dhaillant/midi8d/hardware/MIDI8d-V1.0-schematics-20210517.pdf

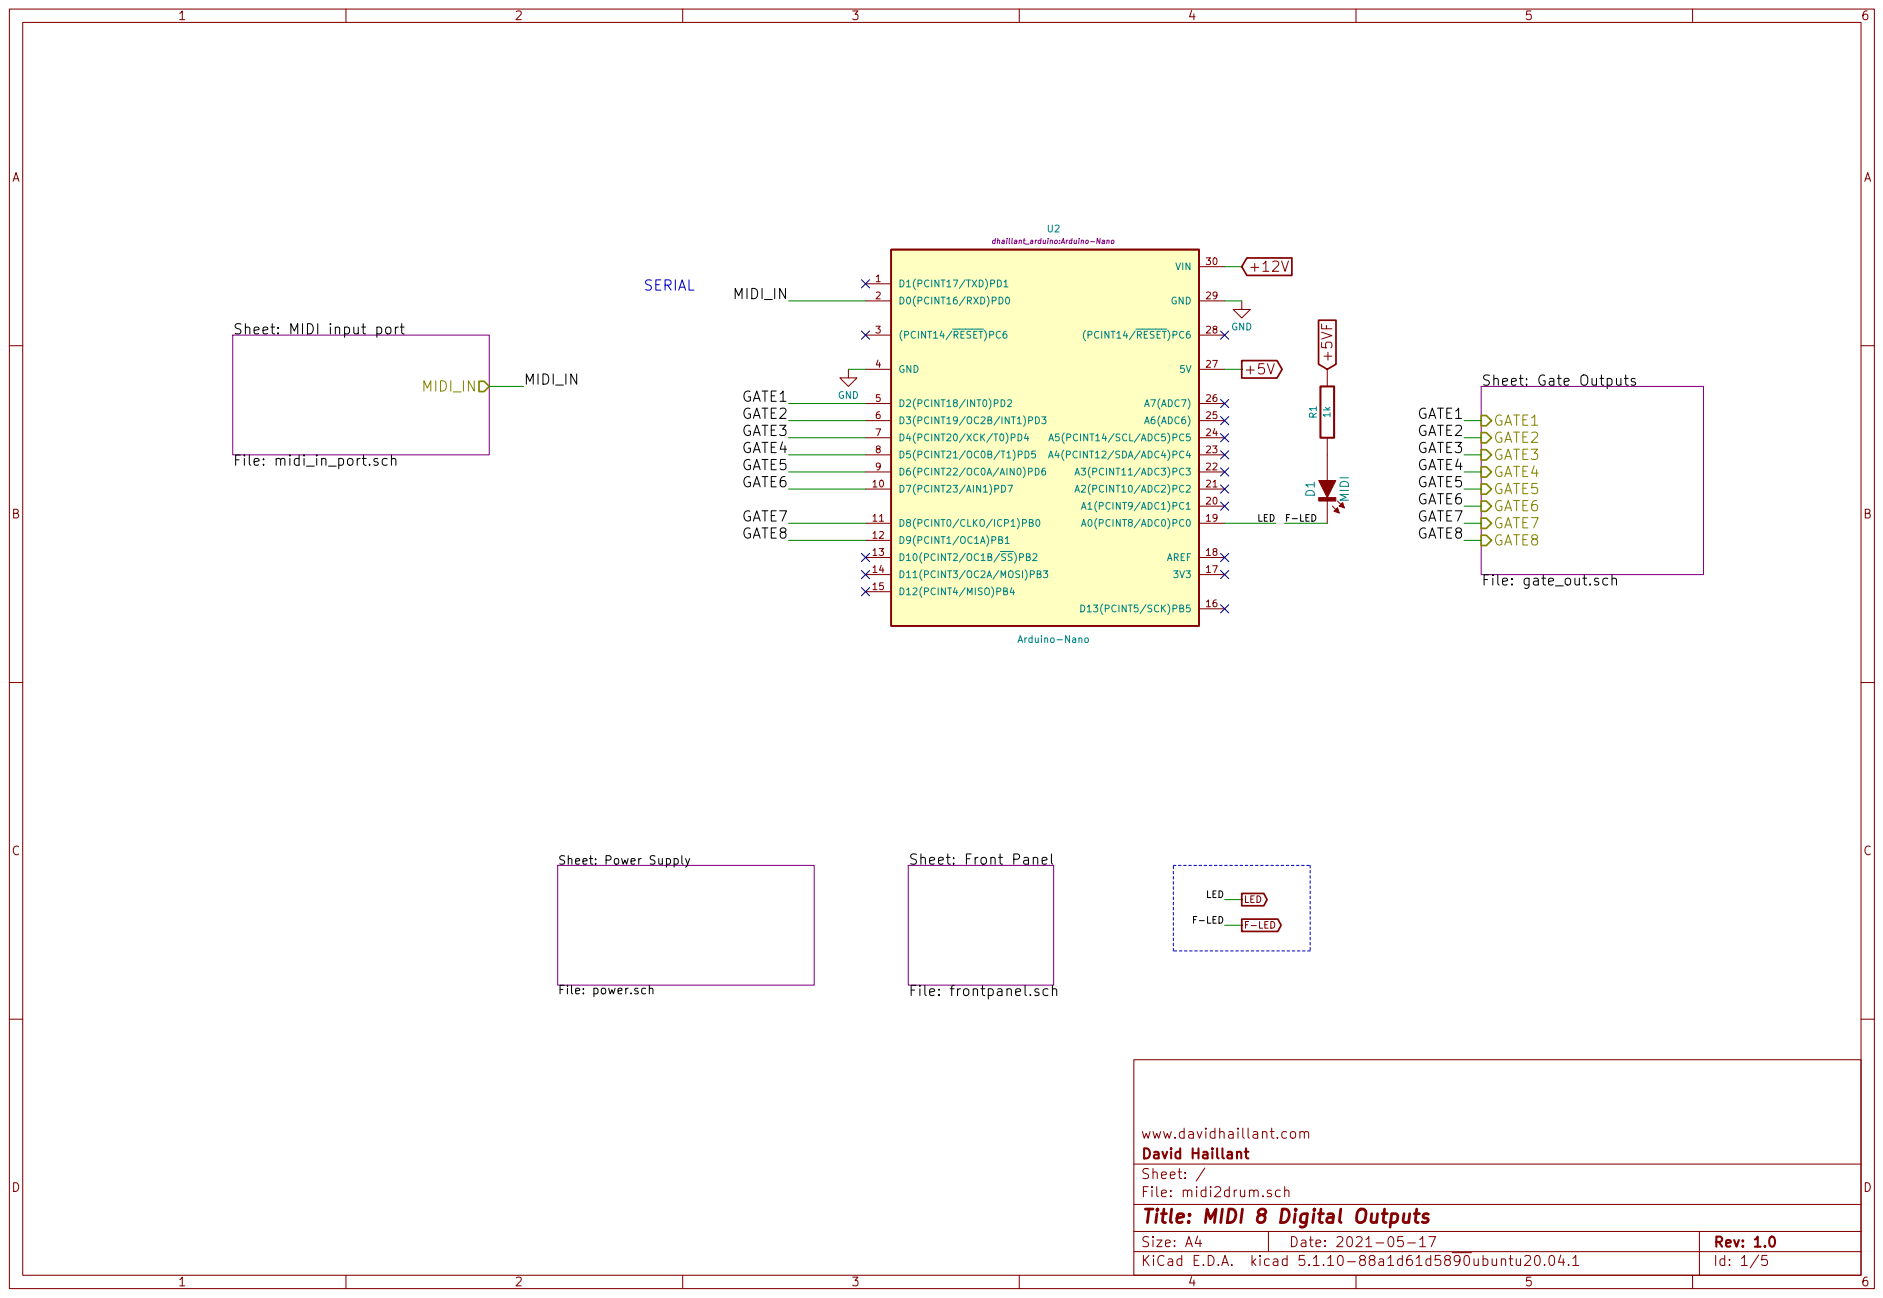
[picture p1: page 1]

Sheet: MIDI input port

File: midi2drum.sch Sheet: / David Haillant www.davidhaillant.com

Id: 1/5 Title: MIDI 8 Digital Outputs

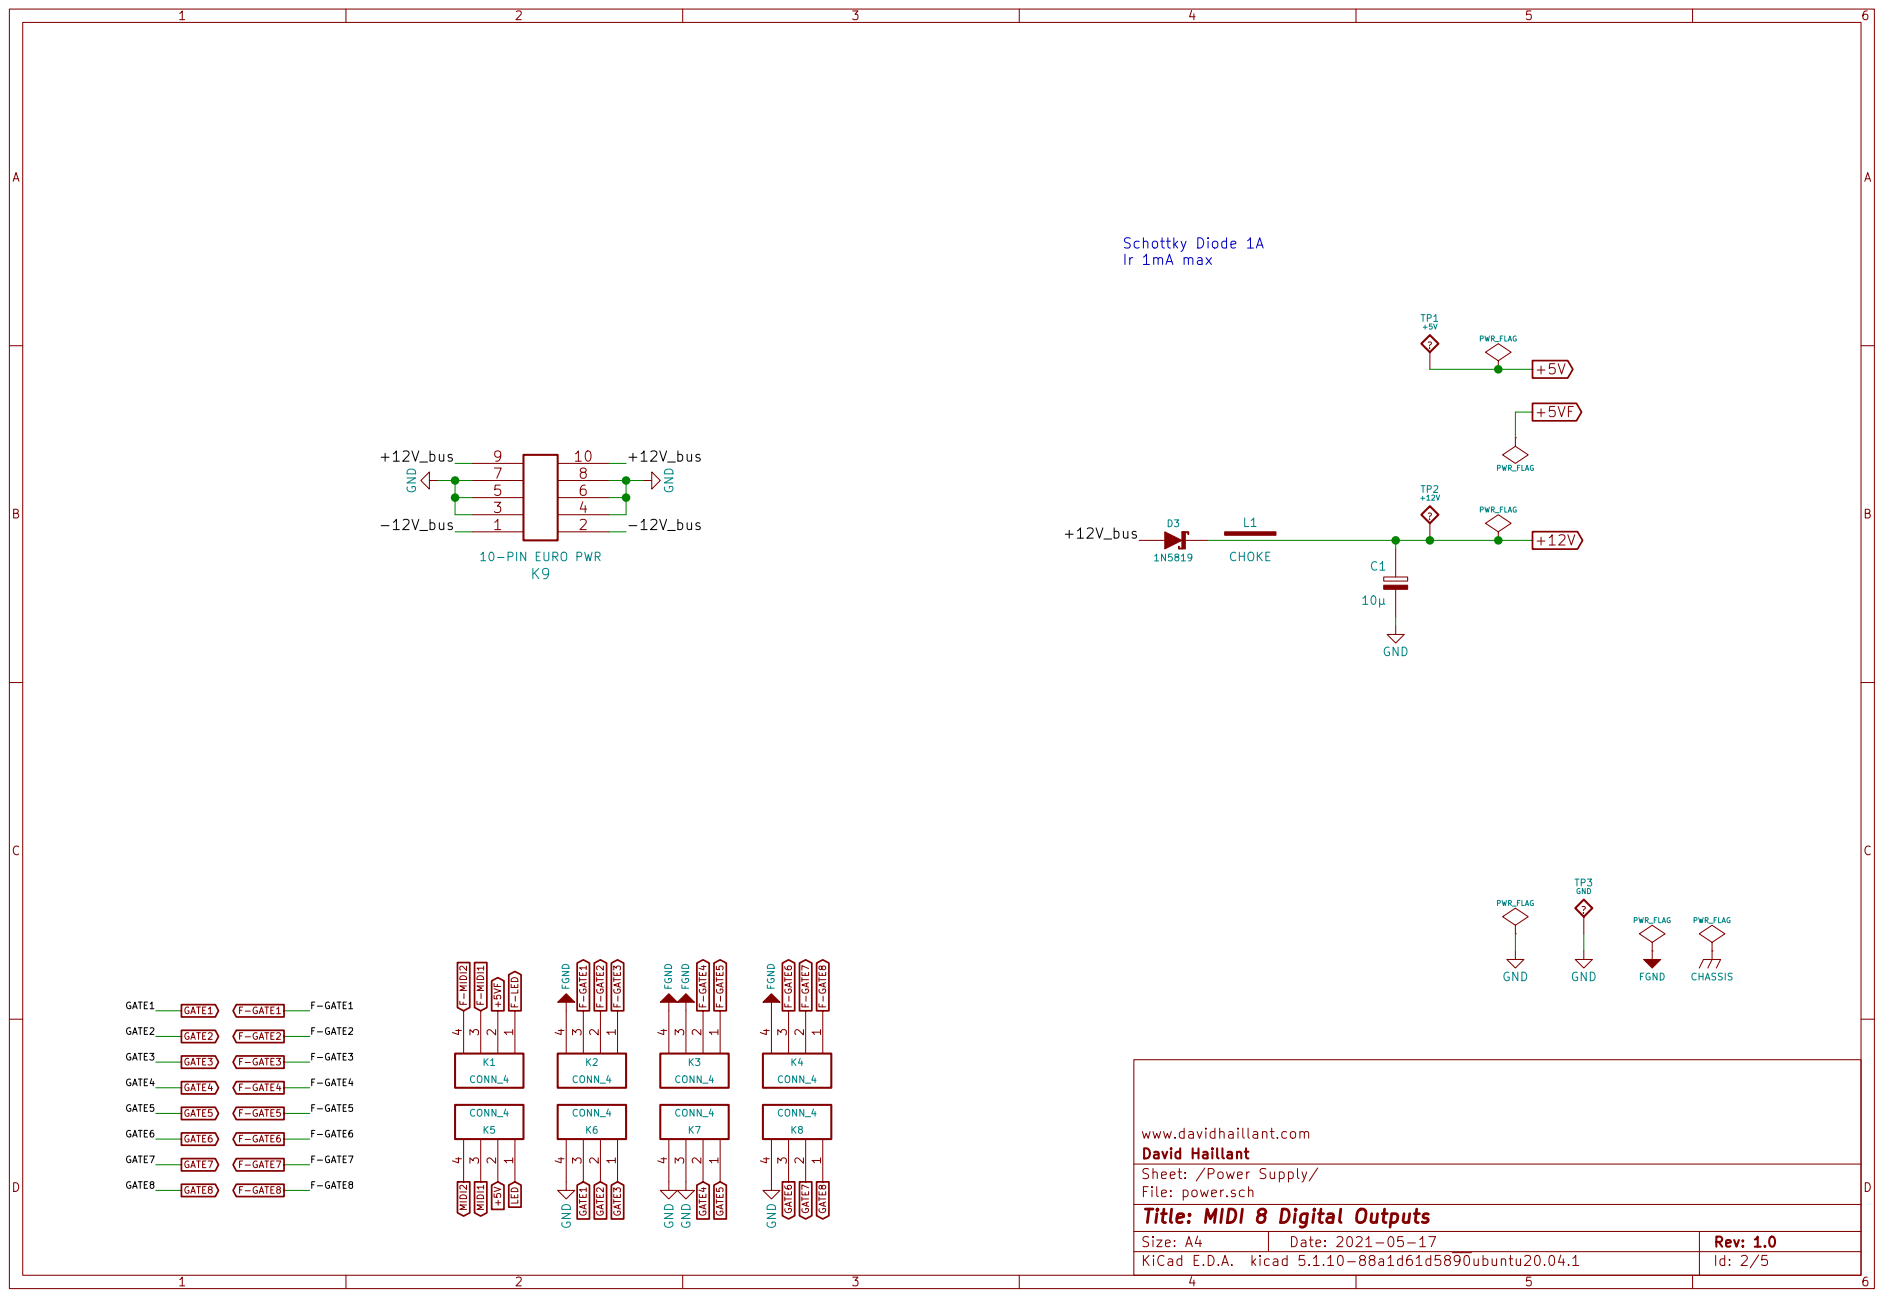
[picture p2: page 2]

Sheet: /Power Supply/ David Haillant www.davidhaillant.com

File: power.sch
Id: 2/5 Title: MIDI 8 Digital Outputs

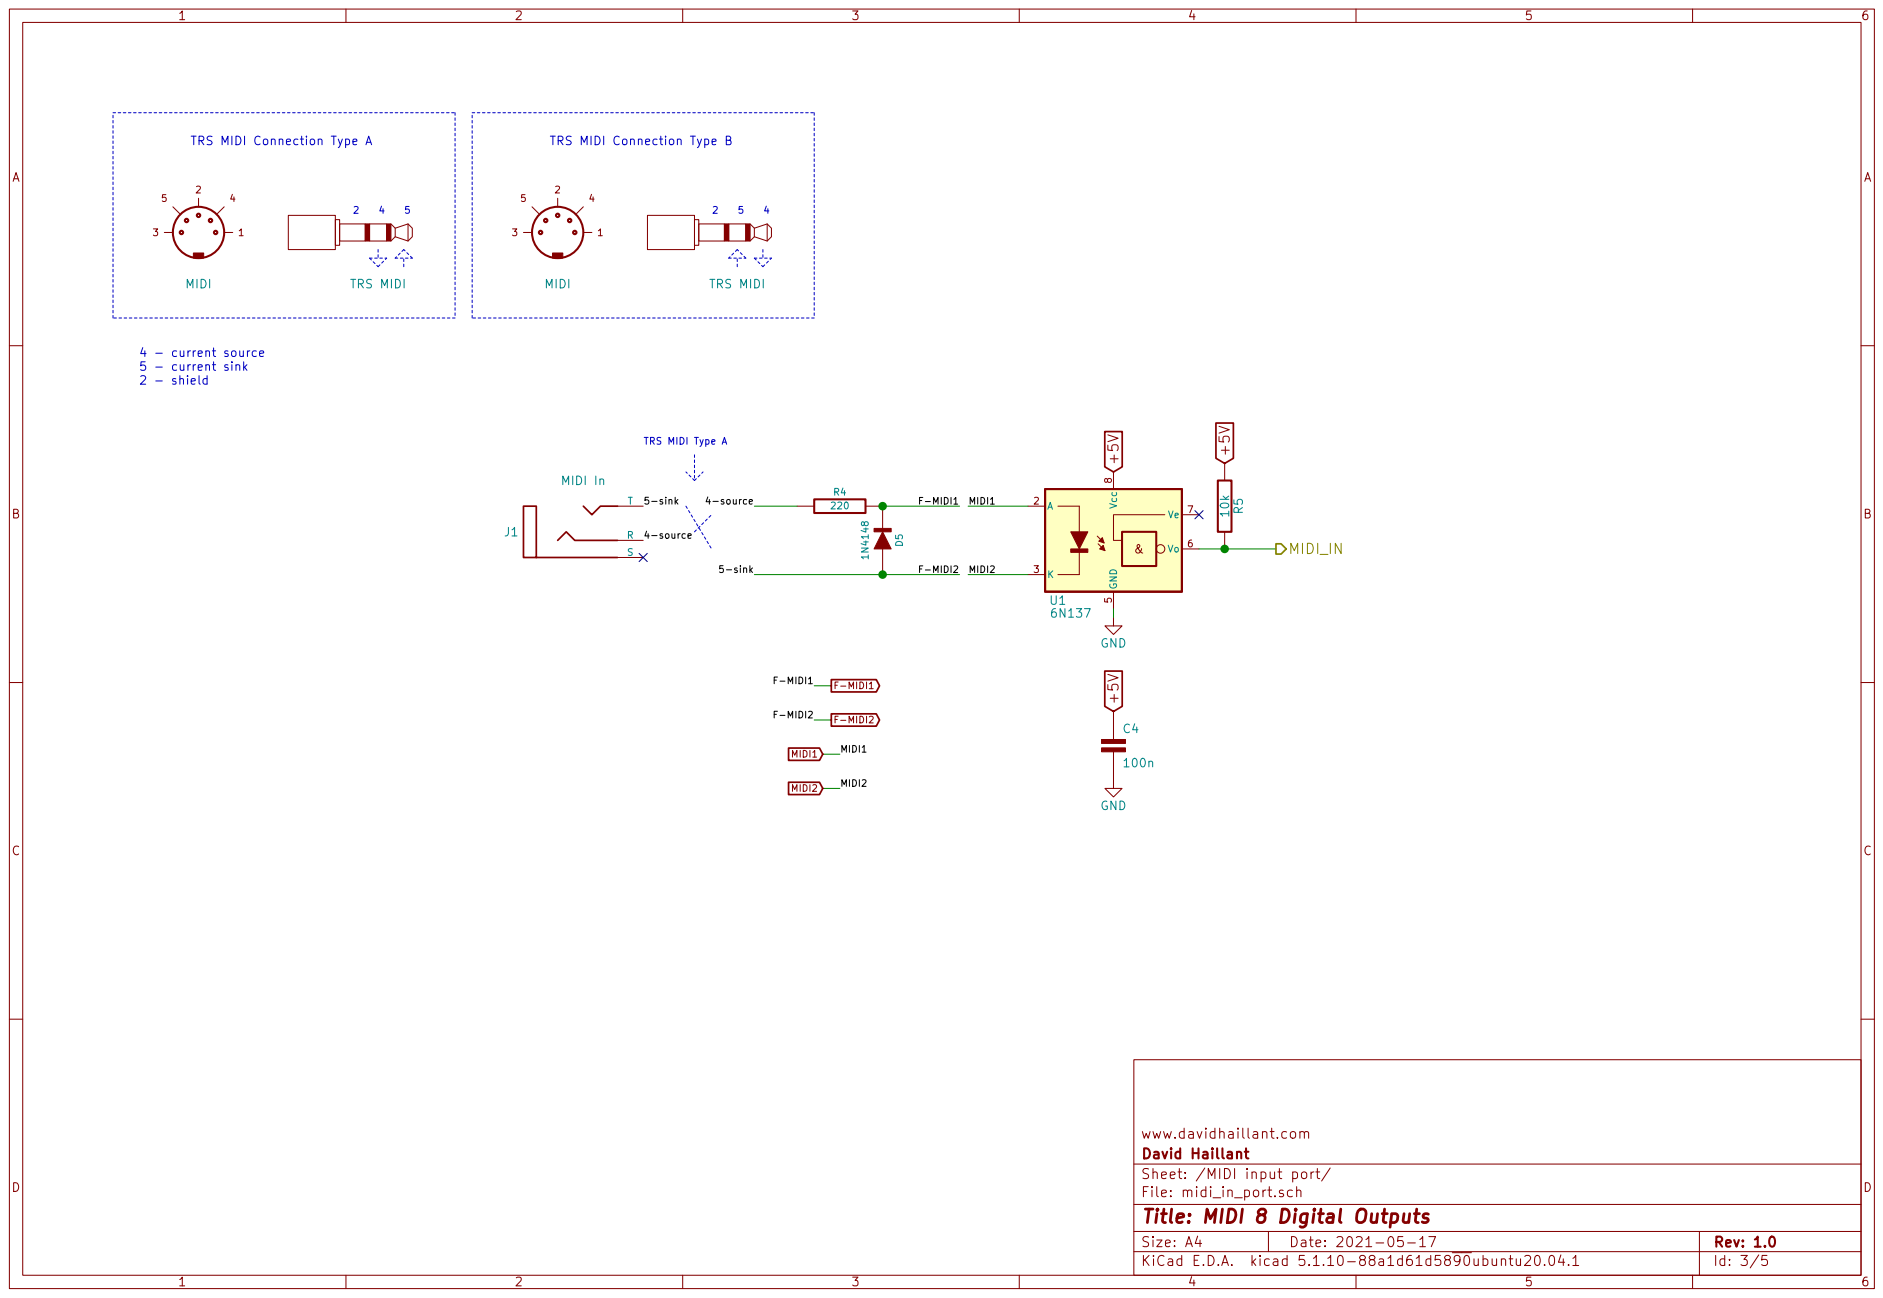
[picture p3: page 3]

Sheet: /MIDI input port/ David Haillant www.davidhaillant.com D5 1N4148

File: midi_in_port.sch
Id: 3/5 Title: MIDI 8 Digital Outputs

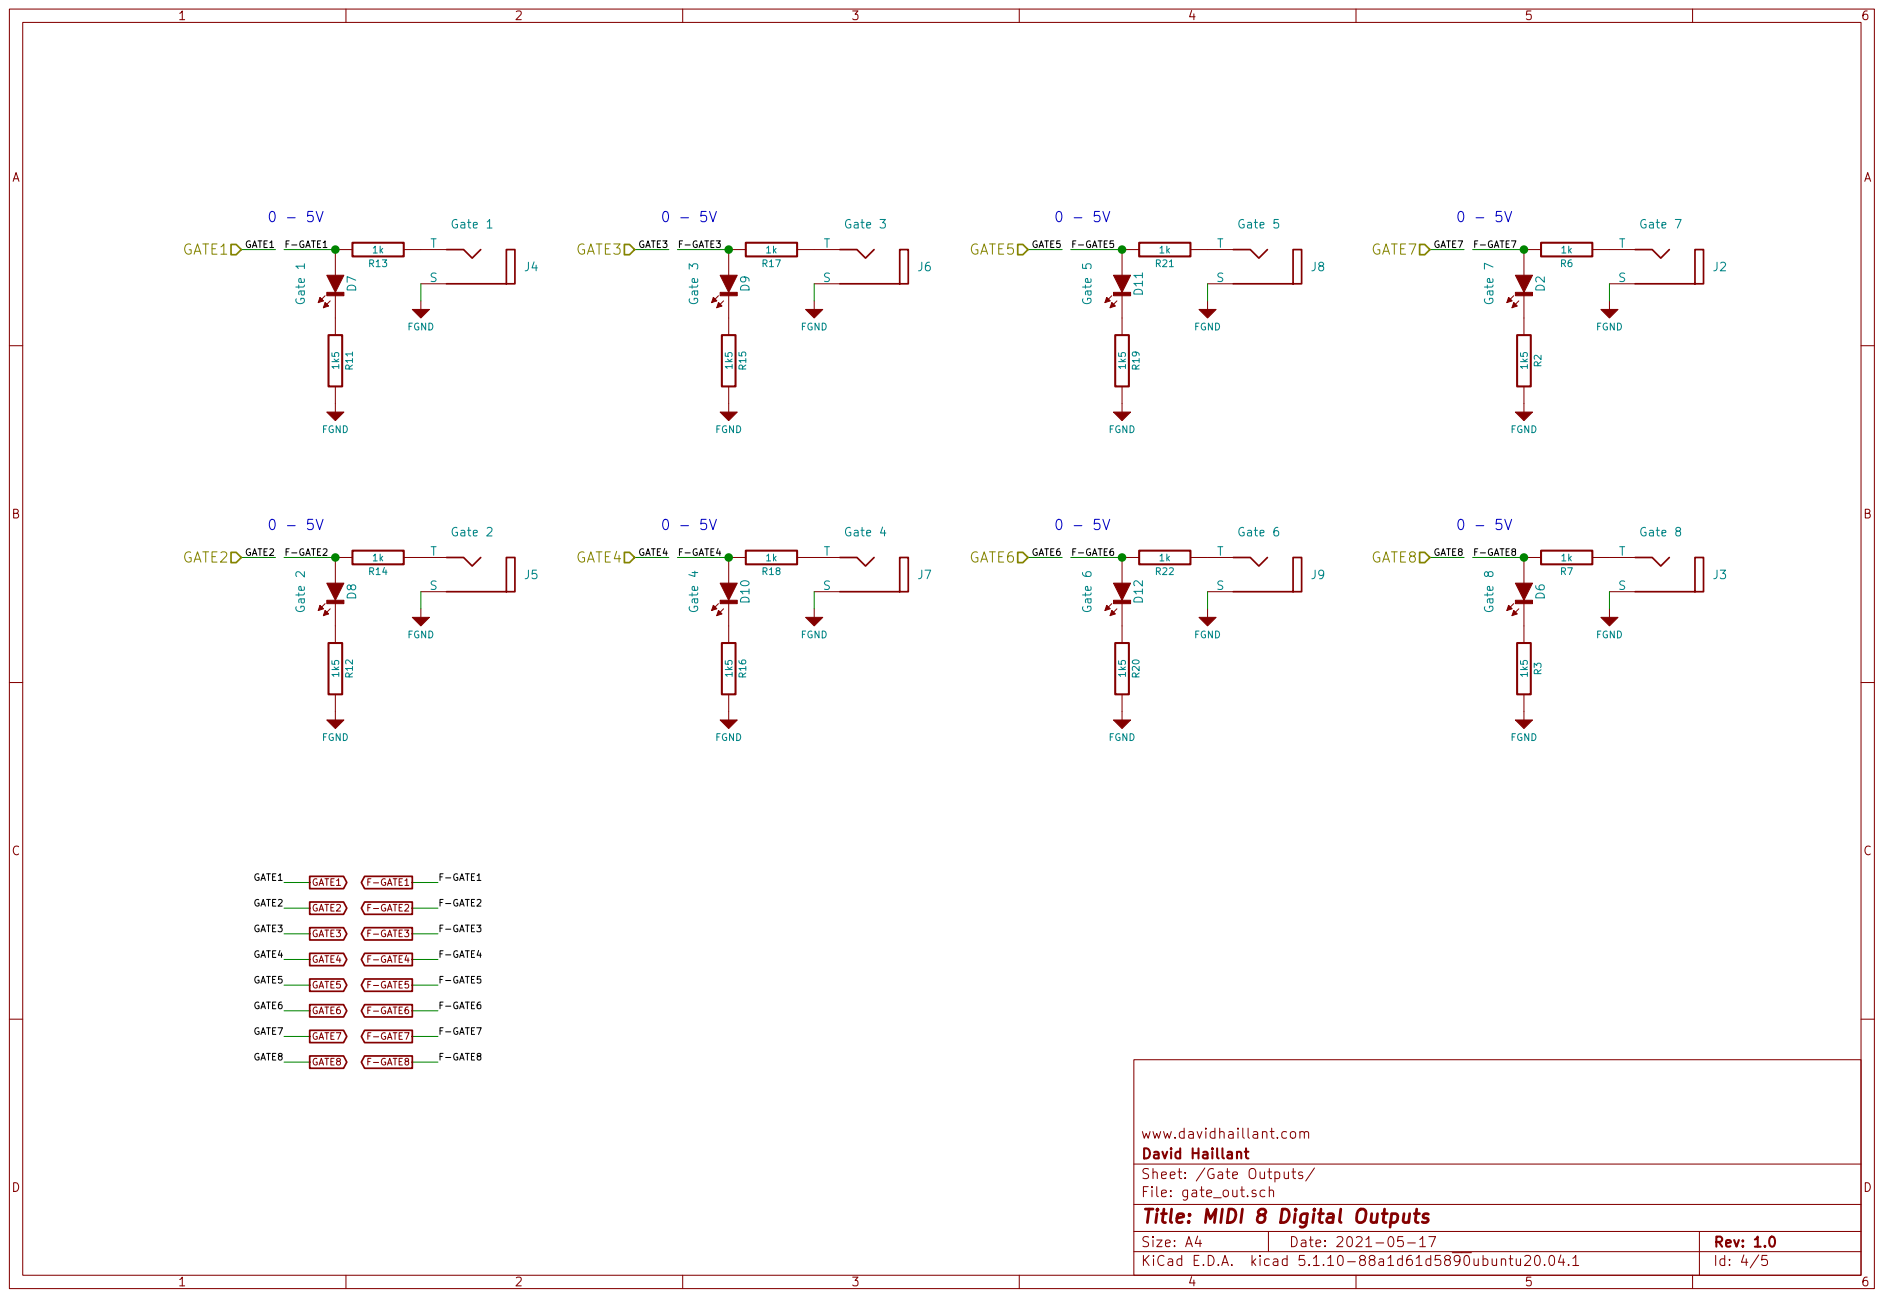
[picture p4: page 4]

File: gate_out.sch
Id: 4/5 Title: MIDI 8 Digital Outputs

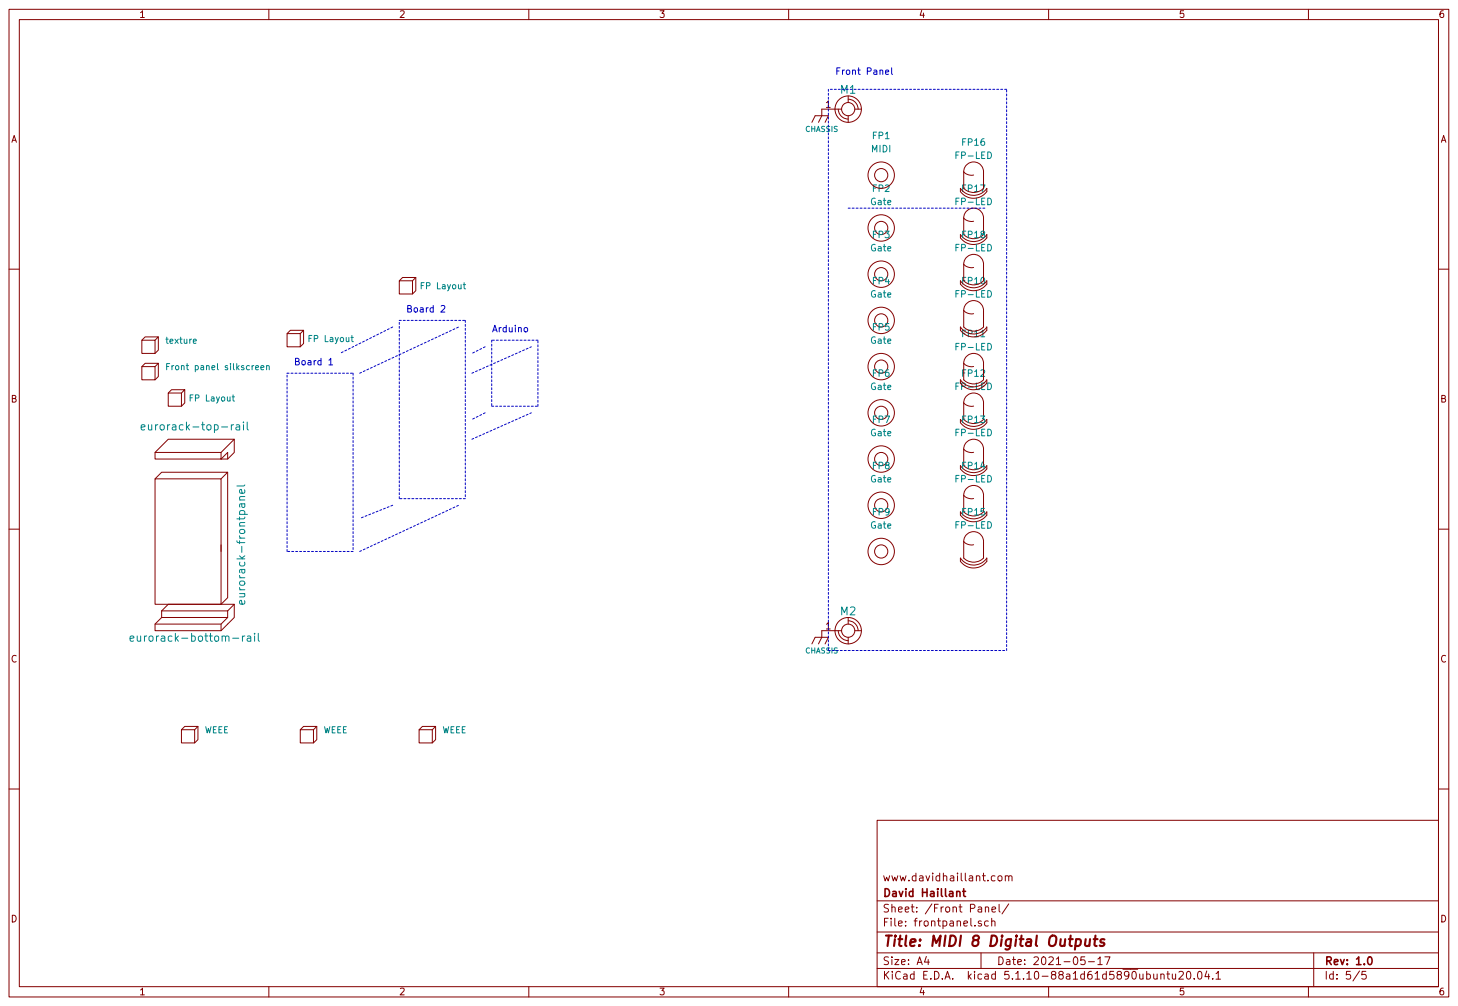
[picture p5: page 5]

FP2 Gate FP3 Gate FP4 Gate FP5 Gate FP6 Gate FP7 Gate FP8 Gate FP9 Gate eurorack-frontpanel

eurorack-top-rail eurorack-bottom-rail

File: frontpanel.sch Sheet: /Front Panel/ David Haillant www.davidhaillant.com

Id: 5/5 Title: MIDI 8 Digital Outputs
