dhaillant/midi8d/(commit log)

2021-05-15 MIDI channel is already filtered
2022-08-28 Incorrect pin reference MIDI_LED_PIN
2023-09-20 Added PWM test project for MIDI8d plus
2023-12-04 first tests and demo for new PWM variant
2023-12-04 pitch test for PWM
2023-12-15 New PWM demos and Rename files
2024-01-18 Added option to select HW version for different pin assignments, and hello world blinks
2024-01-19 Informations on HW versions and different pin assignments
2025-01-31 MIDI LED blink: write to output only when needed
2025-01-31 no-delay blink for MIDI LED
